WBK-Robotics/industrial-assembly-taskboard/docs/source/images/housing_part1_placement.png

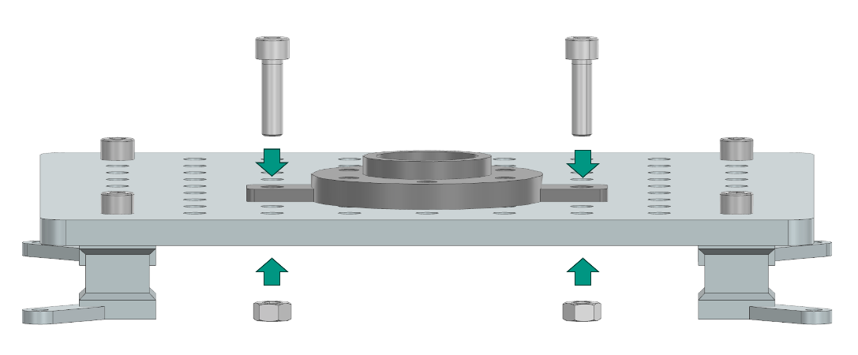
docs/source/images/housing_part1_placement.png
