WBK-Robotics/industrial-assembly-taskboard/docs/source/images/pick_and_place_taskboard.png

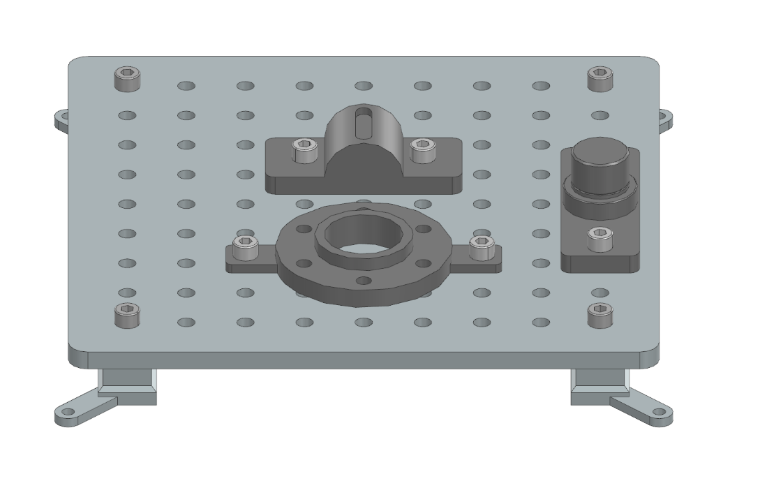
docs/source/images/pick_and_place_taskboard.png
