WBK-Robotics/industrial-assembly-taskboard/docs/source/images/pick_and_place_taskboard_feather_key.png

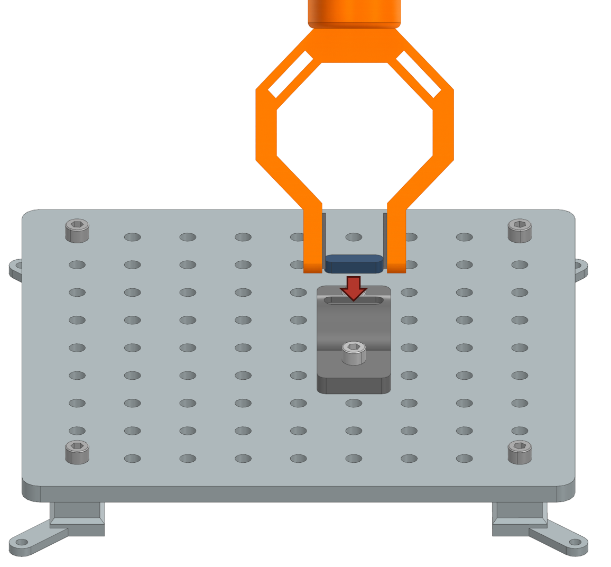
docs/source/images/pick_and_place_taskboard_feather_key.png
