WBK-Robotics/industrial-assembly-taskboard/docs/source/images/pick_and_place_taskboard_shim_rings.png

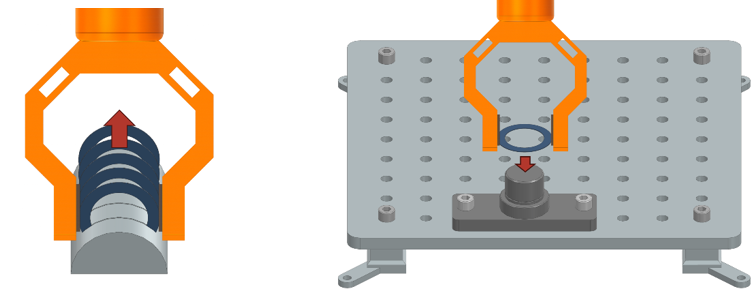
docs/source/images/pick_and_place_taskboard_shim_rings.png
