WBK-Robotics/industrial-assembly-taskboard/docs/source/images/pick_and_place_taskboard_housing_parts.png

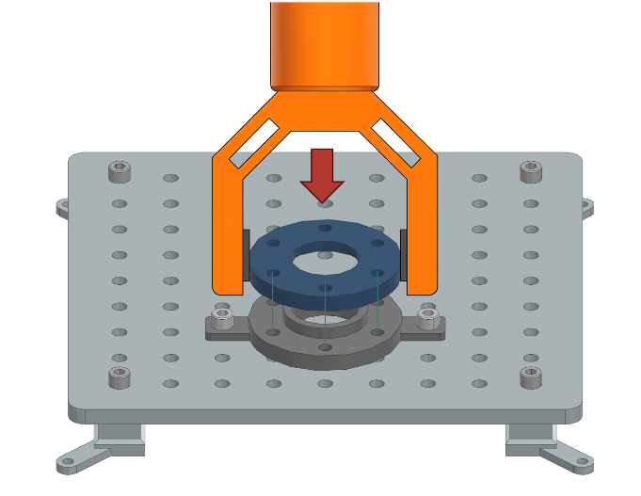
docs/source/images/pick_and_place_taskboard_housing_parts.png
