WBK-Robotics/industrial-assembly-taskboard/3d_printing_files/2 Pick and Place Tasks/Task2-Feather Key/STL/Feather Key Assembly.stl

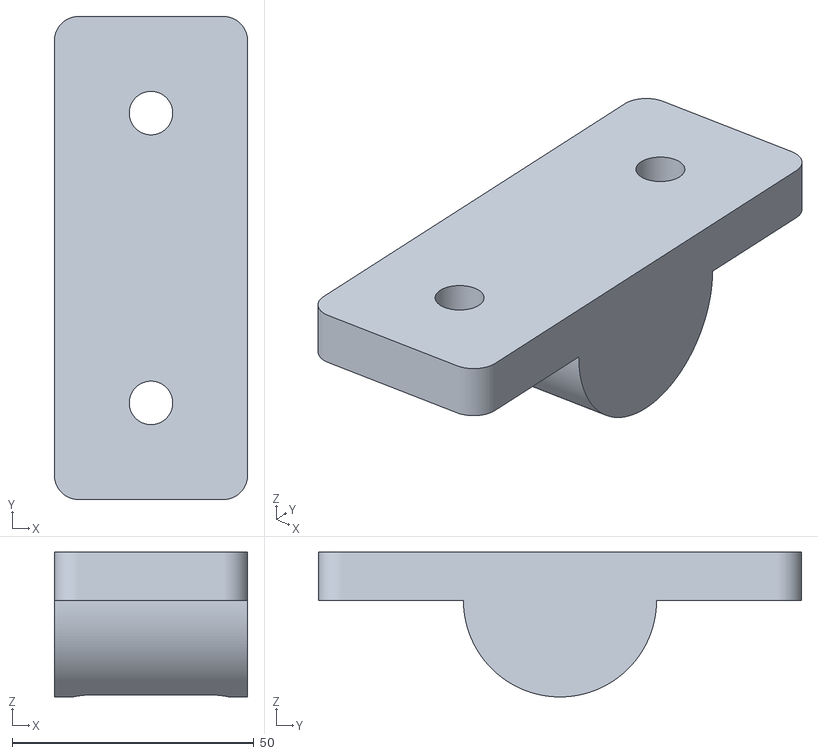
[picture p9: CAD file, 2025-06-06]
3d_printing_files/2 Pick and Place Tasks/Task2-Feather Key/STL/Feather Key Assembly.stl
40.0 x 100.0 x 30.0
