WBK-Robotics/industrial-assembly-taskboard/3d_printing_files/5 Elastic Deformation Tasks/Task1_Snap Hook/STL/Snap Hook Assembly.stl

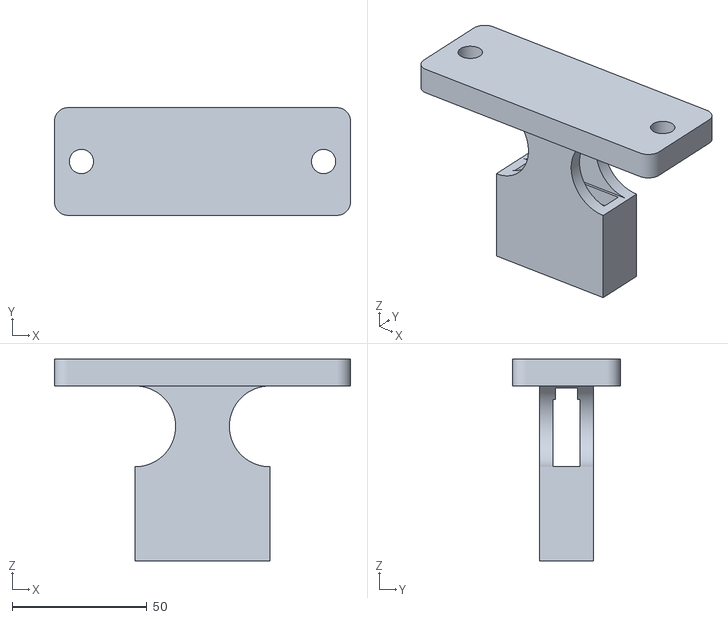
[picture p10: CAD file, 2025-06-06]
3d_printing_files/5 Elastic Deformation Tasks/Task1_Snap Hook/STL/Snap Hook Assembly.stl
110.0 x 40.0 x 75.0
