WBK-Robotics/industrial-assembly-taskboard/3d_printing_files/5 Elastic Deformation Tasks/Task2_Spring/Pressure Spring Assembly.stl

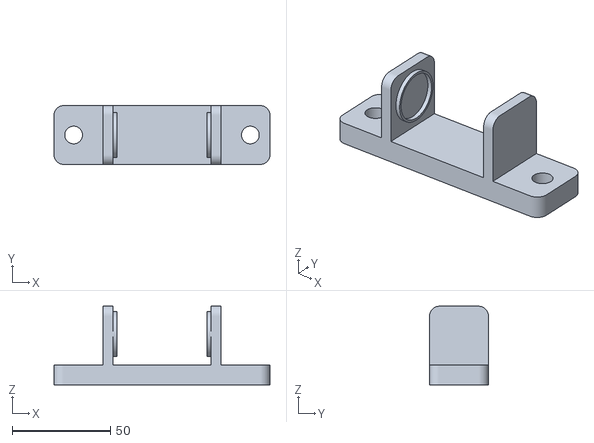
[picture p11: CAD file, 2025-06-06]
3d_printing_files/5 Elastic Deformation Tasks/Task2_Spring/Pressure Spring Assembly.stl
110.0 x 30.0 x 40.0
