WBK-Robotics/industrial-assembly-taskboard/3d_printing_files/5 Elastic Deformation Tasks/Task3_Circlip/Circlip Assembly.stl

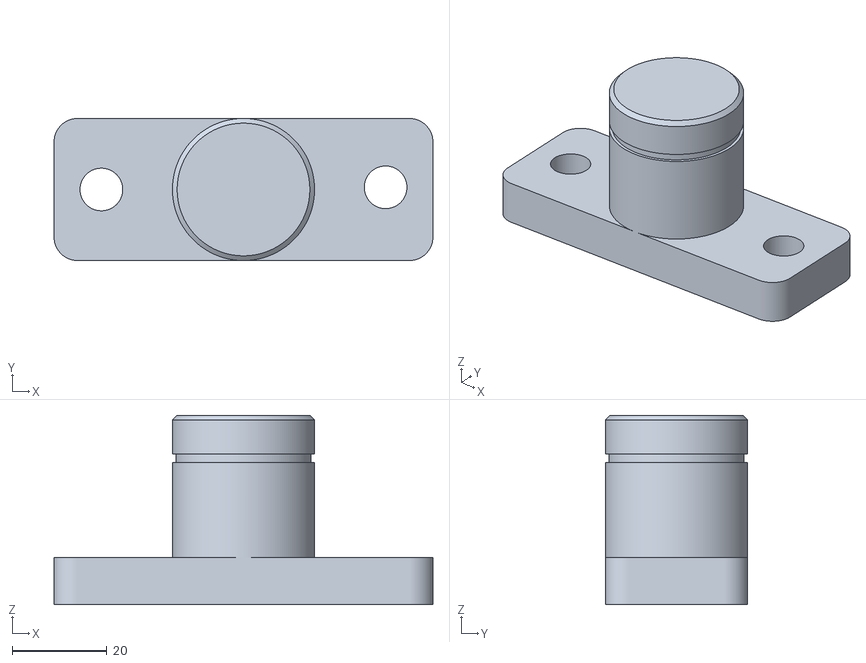
[picture p12: CAD file, 2025-06-06]
3d_printing_files/5 Elastic Deformation Tasks/Task3_Circlip/Circlip Assembly.stl
80.0 x 30.0 x 40.0
