WBK-Robotics/industrial-assembly-taskboard/3d_printing_files/2 Pick and Place Tasks/Task3-Shim Ring/STL/Shim Ring Assembly.stl

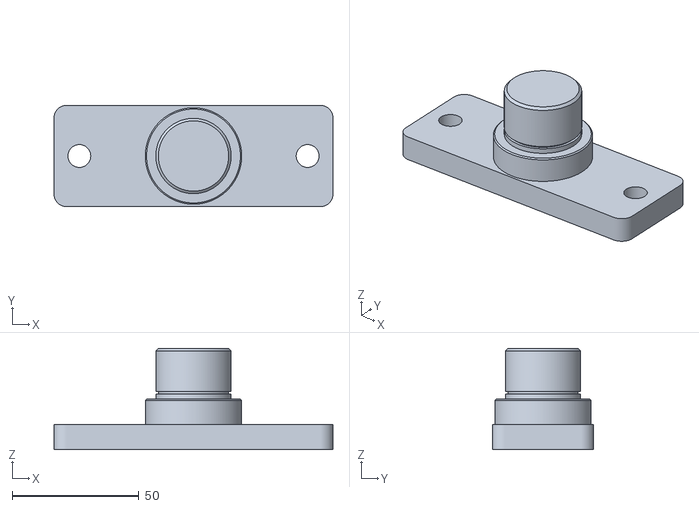
[picture p13: CAD file, 2025-06-06]
3d_printing_files/2 Pick and Place Tasks/Task3-Shim Ring/STL/Shim Ring Assembly.stl
110.0 x 40.0 x 40.0
