WBK-Robotics/industrial-assembly-taskboard/3d_printing_files/1 Peg in Hole Tasks/Task1-Round Shaft/3D-Print only/STL/Peg Round.stl

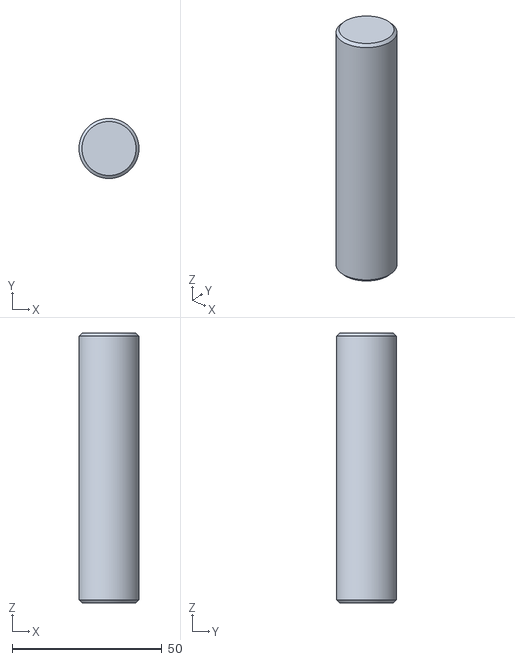
[picture p14: CAD file, 2025-06-06]
3d_printing_files/1 Peg in Hole Tasks/Task1-Round Shaft/3D-Print only/STL/Peg Round.stl
20.0 x 20.0 x 90.0
