WBK-Robotics/industrial-assembly-taskboard/3d_printing_files/1 Peg in Hole Tasks/Task2-Splined Shaft/3D-Printed only/STL/Splined_shaft_peg.stl

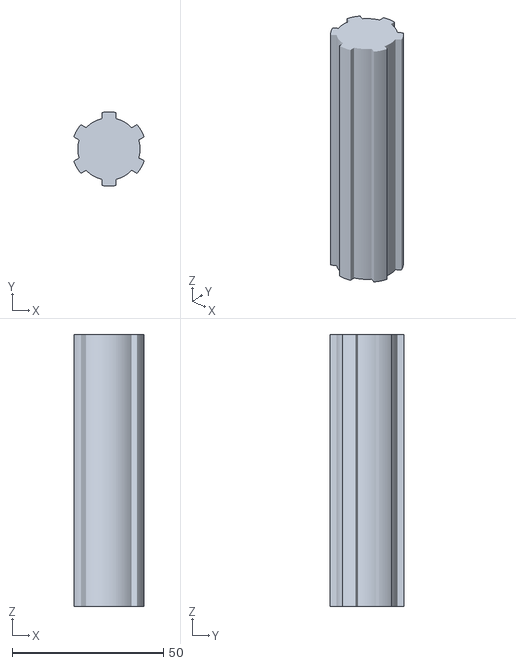
[picture p16: CAD file, 2025-06-06]
3d_printing_files/1 Peg in Hole Tasks/Task2-Splined Shaft/3D-Printed only/STL/Splined_shaft_peg.stl
23.3 x 24.6 x 90.0
