WBK-Robotics/industrial-assembly-taskboard/3d_printing_files/1 Peg in Hole Tasks/Task2-Splined Shaft/Shaft and Sleeve/STL/Hole Splined Shaft.stl

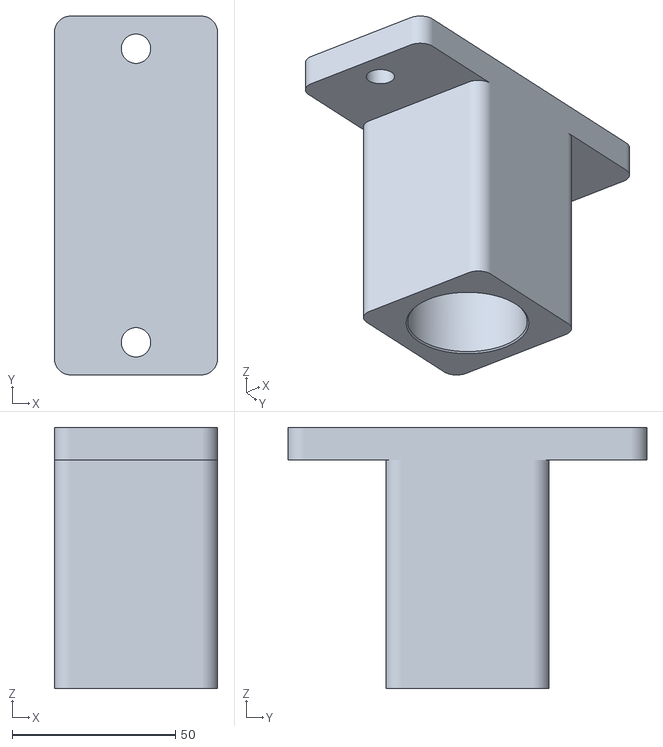
[picture p17: CAD file, 2025-06-06]
3d_printing_files/1 Peg in Hole Tasks/Task2-Splined Shaft/Shaft and Sleeve/STL/Hole Splined Shaft.stl
50.0 x 110.0 x 80.0
