WBK-Robotics/industrial-assembly-taskboard/3d_printing_files/1 Peg in Hole Tasks/Task3-BNC Connector/Mounting BNC Connector.stl

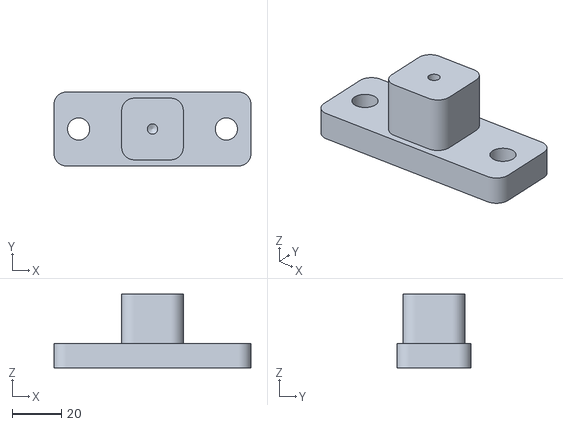
[picture p18: CAD file, 2025-06-06]
3d_printing_files/1 Peg in Hole Tasks/Task3-BNC Connector/Mounting BNC Connector.stl
80.0 x 30.0 x 30.0
