WBK-Robotics/industrial-assembly-taskboard/3d_printing_files/2 Pick and Place Tasks/Task1-Housing/STL/Housing Part2.stl

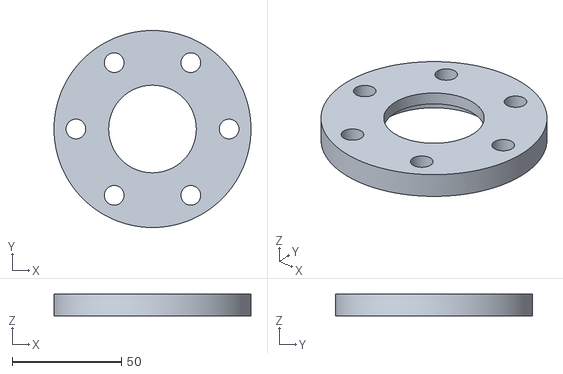
[picture p19: CAD file, 2025-06-06]
3d_printing_files/2 Pick and Place Tasks/Task1-Housing/STL/Housing Part2.stl
90.0 x 90.0 x 10.0
