WBK-Robotics/industrial-assembly-taskboard/3d_printing_files/2 Pick and Place Tasks/Task3-Shim Ring/STL/Shim Ring Magazine.stl

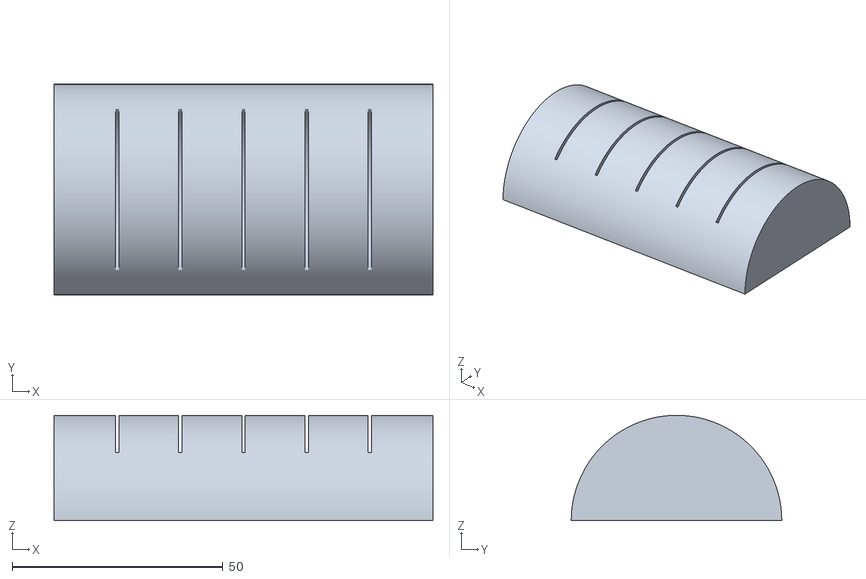
[picture p20: CAD file, 2025-06-06]
3d_printing_files/2 Pick and Place Tasks/Task3-Shim Ring/STL/Shim Ring Magazine.stl
90.0 x 50.0 x 25.0
