WBK-Robotics/industrial-assembly-taskboard/3d_printing_files/3 Gear Assembly Tasks/Task1 2 Gears/STL/2 Gears Mounting.stl

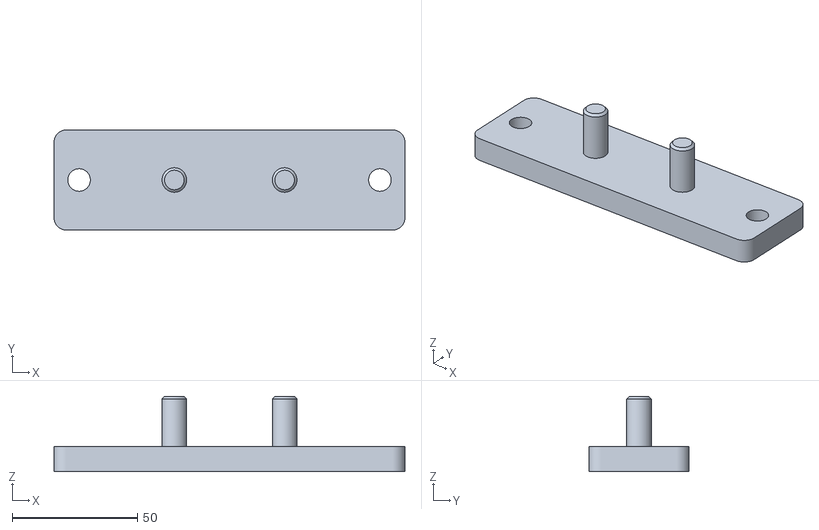
[picture p21: CAD file, 2025-06-06]
3d_printing_files/3 Gear Assembly Tasks/Task1 2 Gears/STL/2 Gears Mounting.stl
140.0 x 40.0 x 30.0
