WBK-Robotics/industrial-assembly-taskboard/3d_printing_files/3 Gear Assembly Tasks/Task2 2 Gears with helical Teeth/STL/Helical Gear.stl

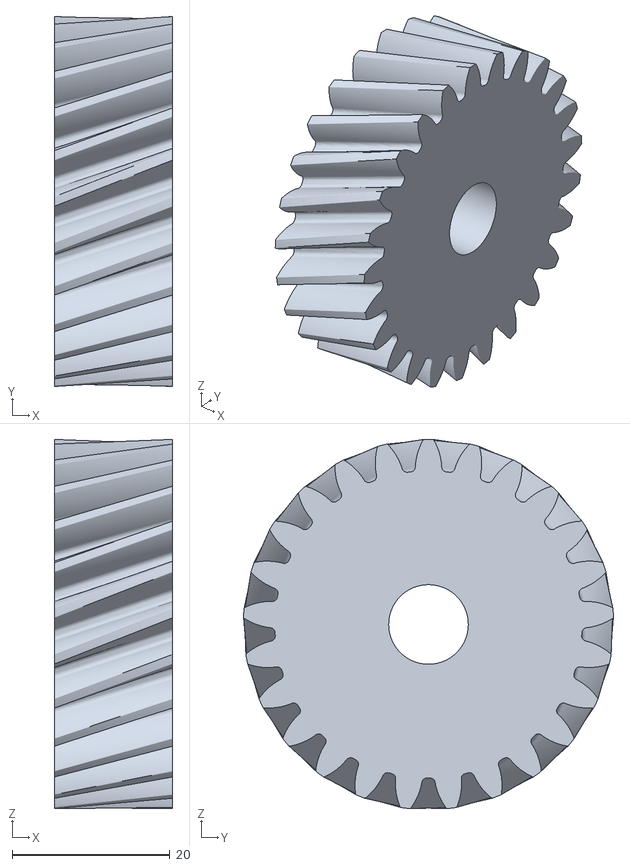
[picture p22: CAD file, 2025-06-06]
3d_printing_files/3 Gear Assembly Tasks/Task2 2 Gears with helical Teeth/STL/Helical Gear.stl
15.0 x 47.0 x 46.9
