WBK-Robotics/industrial-assembly-taskboard/3d_printing_files/3 Gear Assembly Tasks/Task3 3 Gears/STL/Gear 3 with Groove_2pcs.stl

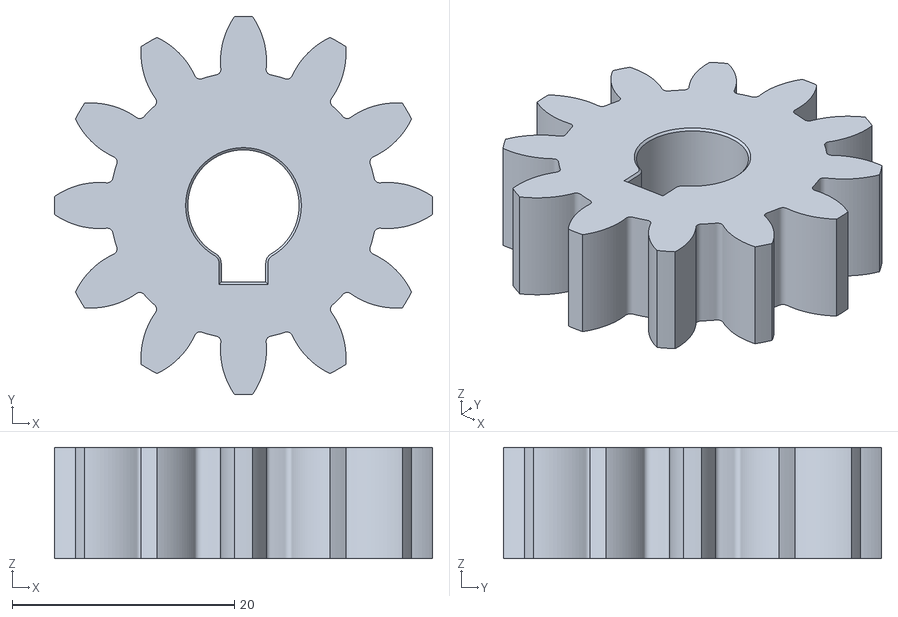
[picture p23: CAD file, 2025-06-06]
3d_printing_files/3 Gear Assembly Tasks/Task3 3 Gears/STL/Gear 3 with Groove_2pcs.stl
34.0 x 34.0 x 10.0
