WBK-Robotics/industrial-assembly-taskboard/3d_printing_files/Taskboard/STL/Taskboard.stl

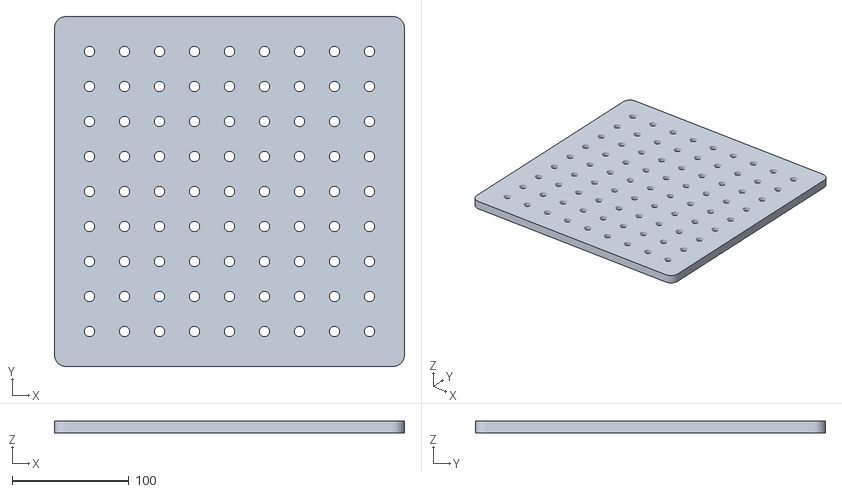
[picture p24: CAD file, 2025-06-24]
3d_printing_files/Taskboard/STL/Taskboard.stl
300.0 x 300.0 x 10.0
