WBK-Robotics/industrial-assembly-taskboard/3d_printing_files/1 Peg in Hole Tasks/Task1-Round Shaft/3D-Print only/STL/Hole Round.stl

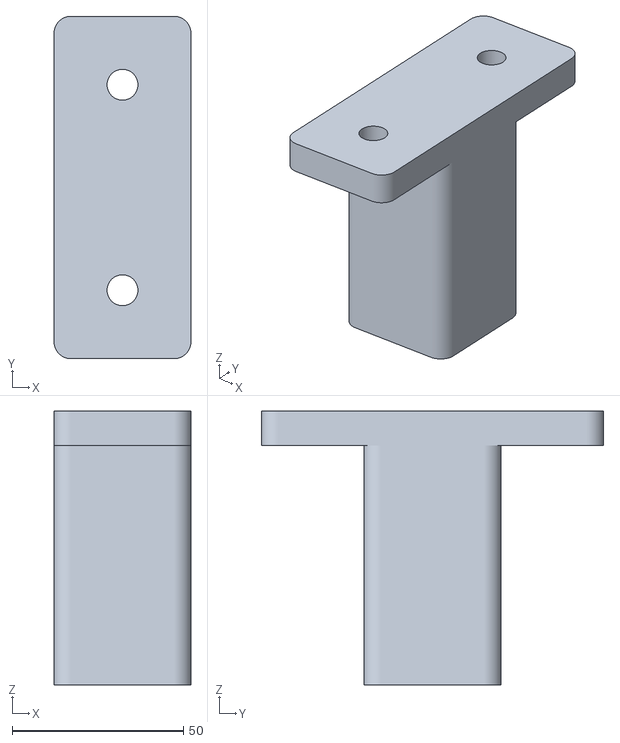
[picture p25: CAD file, 2025-06-06]
3d_printing_files/1 Peg in Hole Tasks/Task1-Round Shaft/3D-Print only/STL/Hole Round.stl
40.0 x 100.0 x 80.0
