WBK-Robotics/industrial-assembly-taskboard/3d_printing_files/1 Peg in Hole Tasks/Task2-Splined Shaft/3D-Printed only/STL/Splined_shaft_hole.stl

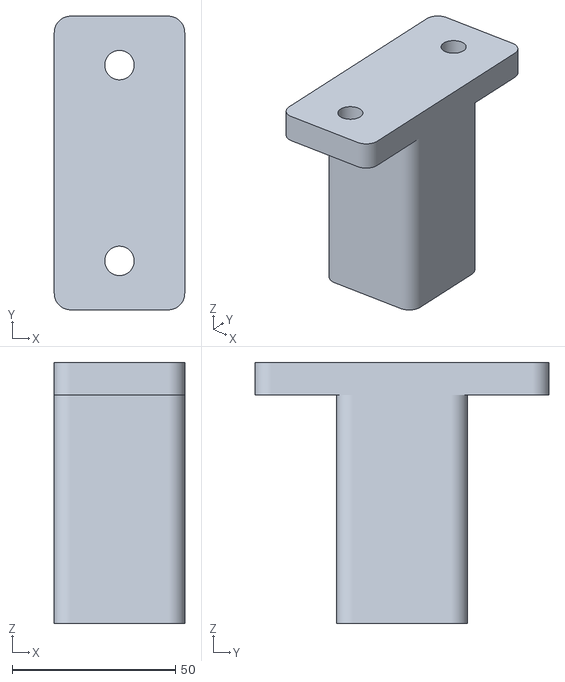
[picture p26: CAD file, 2025-06-06]
3d_printing_files/1 Peg in Hole Tasks/Task2-Splined Shaft/3D-Printed only/STL/Splined_shaft_hole.stl
40.0 x 90.0 x 80.0
