WBK-Robotics/industrial-assembly-taskboard/3d_printing_files/2 Pick and Place Tasks/Task2-Feather Key/STL/Feather Key.stl

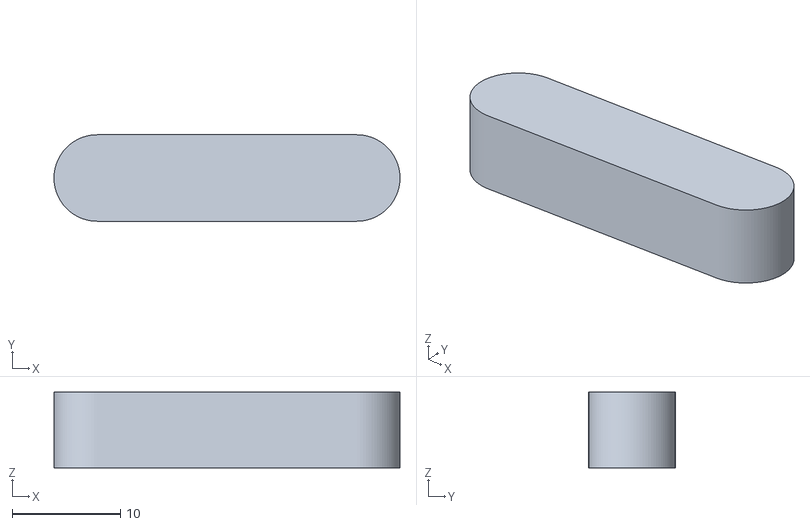
[picture p28: CAD file, 2025-06-06]
3d_printing_files/2 Pick and Place Tasks/Task2-Feather Key/STL/Feather Key.stl
32.0 x 8.00 x 7.00
