WBK-Robotics/industrial-assembly-taskboard/3d_printing_files/3 Gear Assembly Tasks/Task1 2 Gears/STL/Gear 1.stl

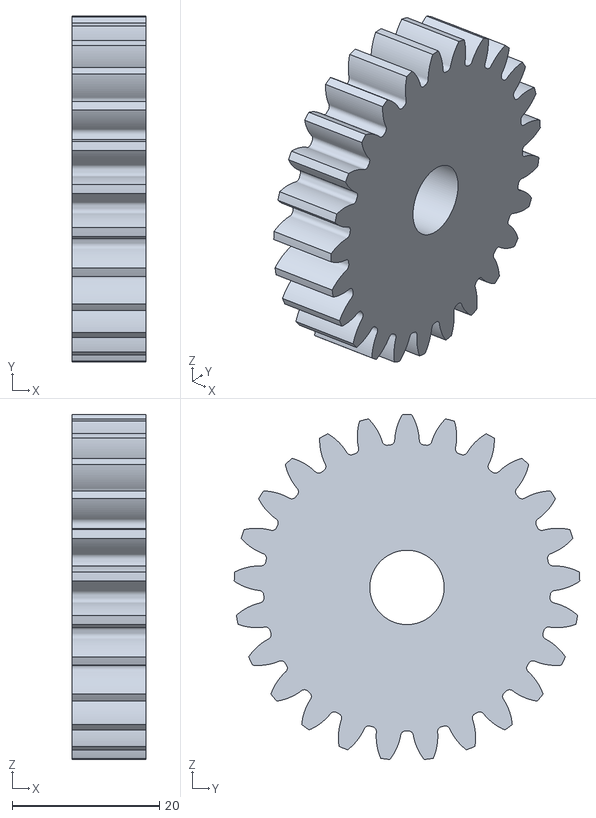
[picture p29: CAD file, 2025-06-06]
3d_printing_files/3 Gear Assembly Tasks/Task1 2 Gears/STL/Gear 1.stl
10.0 x 47.0 x 46.9
