WBK-Robotics/industrial-assembly-taskboard/3d_printing_files/3 Gear Assembly Tasks/Task3 3 Gears/STL/3 Gears Mounting Part 1.stl

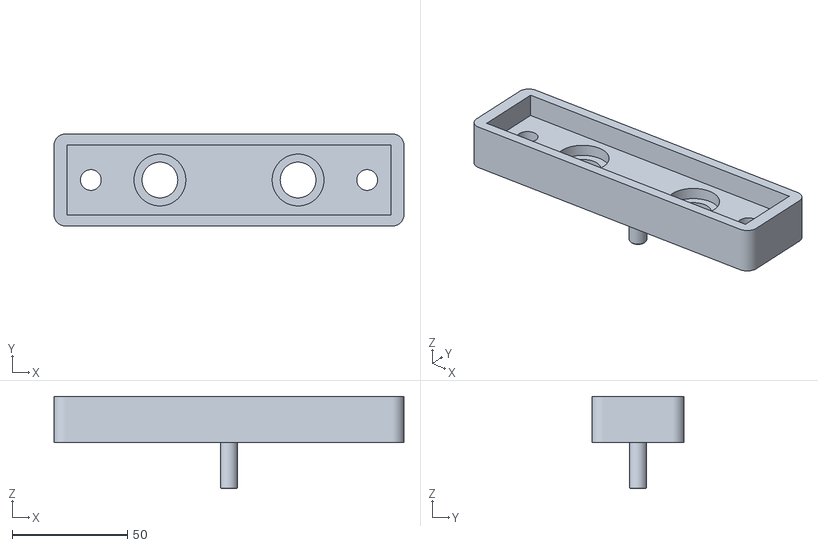
[picture p30: CAD file, 2025-06-06]
3d_printing_files/3 Gear Assembly Tasks/Task3 3 Gears/STL/3 Gears Mounting Part 1.stl
152.0 x 40.0 x 40.0
