WBK-Robotics/industrial-assembly-taskboard/3d_printing_files/5 Elastic Deformation Tasks/Task1_Snap Hook/STL/Snap Hook (horizontal 3D printing).stl

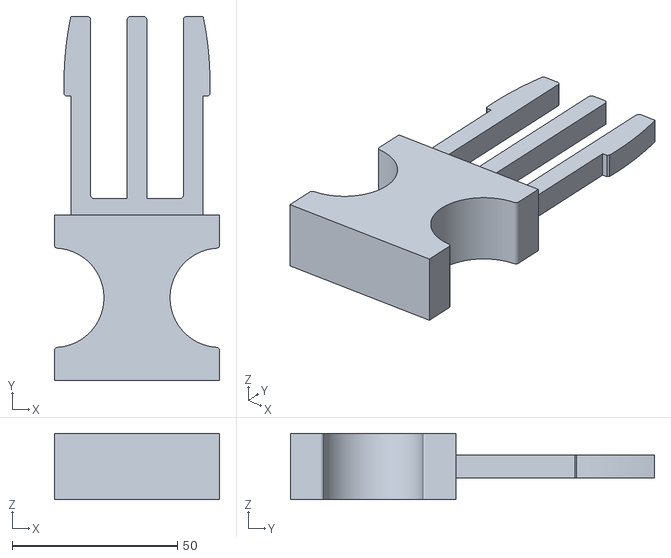
[picture p31: CAD file, 2025-06-06]
3d_printing_files/5 Elastic Deformation Tasks/Task1_Snap Hook/STL/Snap Hook (horizontal 3D printing).stl
50.0 x 110.0 x 20.0
