WBK-Robotics/industrial-assembly-taskboard/3d_printing_files/Taskboard/STL/Taskboard Foot-4pcs.stl

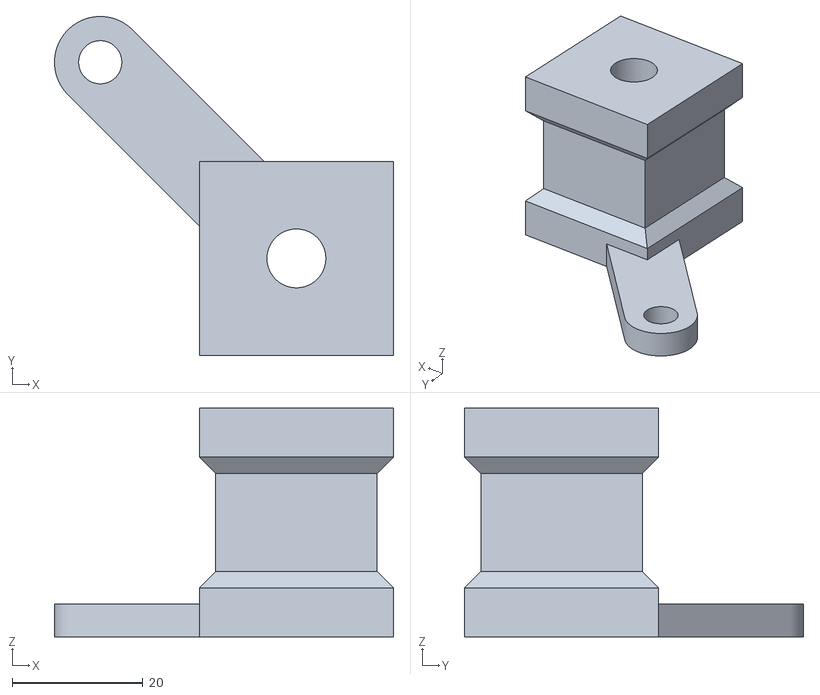
[picture p32: CAD file, 2025-06-24]
3d_printing_files/Taskboard/STL/Taskboard Foot-4pcs.stl
51.8 x 51.8 x 35.0
