WBK-Robotics/industrial-assembly-taskboard/3d_printing_files/3 Gear Assembly Tasks/Task3 3 Gears/STL/Shaft with Key_2pcs.stl

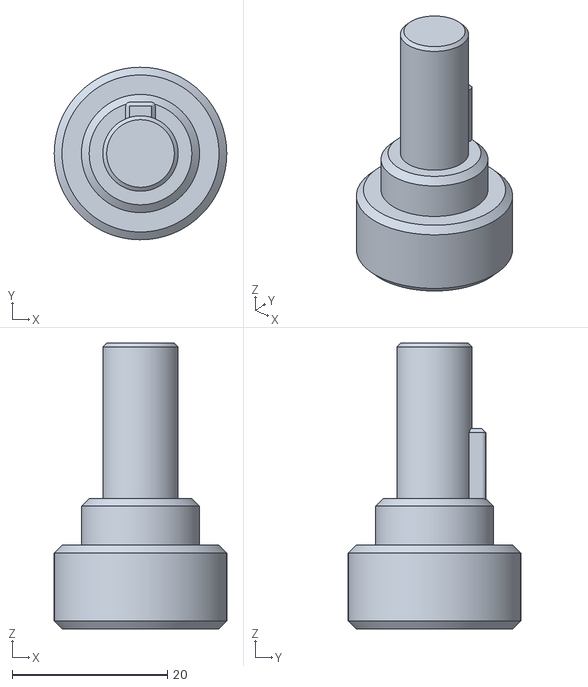
[picture p33: CAD file, 2025-06-06]
3d_printing_files/3 Gear Assembly Tasks/Task3 3 Gears/STL/Shaft with Key_2pcs.stl
22.2 x 22.2 x 36.8
