WBK-Robotics/industrial-assembly-taskboard/3d_printing_files/3 Gear Assembly Tasks/Task3 3 Gears/STL/3 Gears Mounting Part 2.stl

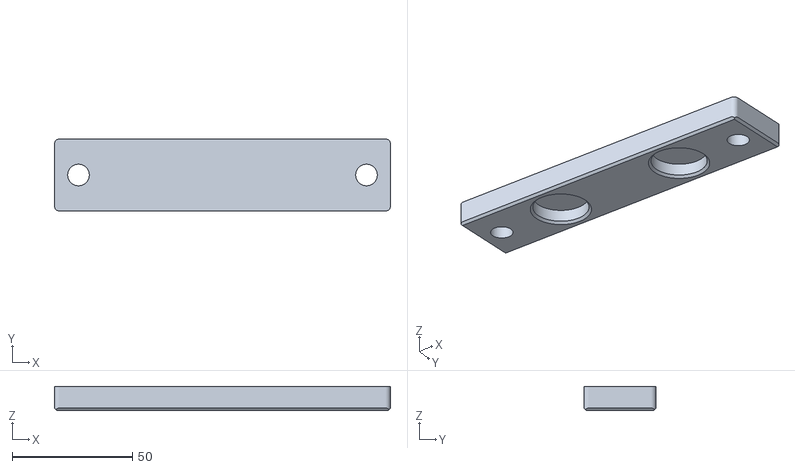
[picture p34: CAD file, 2025-06-06]
3d_printing_files/3 Gear Assembly Tasks/Task3 3 Gears/STL/3 Gears Mounting Part 2.stl
140.0 x 30.0 x 10.0
