WBK-Robotics/industrial-assembly-taskboard/(list of files, cad)

Other CAD files:
3d_printing_files/3 Gear Assembly Tasks/Task3 3 Gears/STL/Gear 3.stl
3d_printing_files/1 Peg in Hole Tasks/Task1-Round Shaft/3D-Print only/CAD/Hole round.prt
3d_printing_files/1 Peg in Hole Tasks/Task1-Round Shaft/3D-Print only/CAD/Peg round.prt
3d_printing_files/1 Peg in Hole Tasks/Task1-Round Shaft/Shaft and Bearing/CAD/Hole round.prt
3d_printing_files/1 Peg in Hole Tasks/Task1-Round Shaft/Shaft and Bearing/CAD/MPBZ20-50_stp.prt
3d_printing_files/1 Peg in Hole Tasks/Task1-Round Shaft/Shaft and Bearing/CAD/PSFG20-100_stp.prt
3d_printing_files/1 Peg in Hole Tasks/Task1-Round Shaft/Shaft and Bearing/CAD/Peg in Hole Assembly.prt
3d_printing_files/1 Peg in Hole Tasks/Task2-Splined Shaft/3D-Printed only/CAD/Hole splined shaft.prt
3d_printing_files/1 Peg in Hole Tasks/Task2-Splined Shaft/3D-Printed only/CAD/Peg splined shaft.prt
3d_printing_files/1 Peg in Hole Tasks/Task2-Splined Shaft/Shaft and Sleeve/CAD/Hole Splined Shaft.prt
3d_printing_files/1 Peg in Hole Tasks/Task2-Splined Shaft/Shaft and Sleeve/CAD/Splined shaft bearing.prt
3d_printing_files/1 Peg in Hole Tasks/Task2-Splined Shaft/Shaft and Sleeve/CAD/Splined shaft.prt
3d_printing_files/1 Peg in Hole Tasks/Task3-BNC Connector/Mounting BNC Connector.prt
3d_printing_files/2 Pick and Place Tasks/Task1-Housing/CAD/Housing Assembly Group.prt
3d_printing_files/2 Pick and Place Tasks/Task1-Housing/CAD/Housing Part1.prt
3d_printing_files/2 Pick and Place Tasks/Task1-Housing/CAD/Housing Part2.prt
3d_printing_files/2 Pick and Place Tasks/Task2-Feather Key/CAD/Assembly Group Feather Key.prt
3d_printing_files/2 Pick and Place Tasks/Task2-Feather Key/CAD/Feather Key Assembly.prt
3d_printing_files/2 Pick and Place Tasks/Task2-Feather Key/CAD/Feather Key.prt
3d_printing_files/2 Pick and Place Tasks/Task3-Shim Ring/CAD/Magazin Filled.prt
3d_printing_files/2 Pick and Place Tasks/Task3-Shim Ring/CAD/Shim Ring Assembly Group.prt
3d_printing_files/2 Pick and Place Tasks/Task3-Shim Ring/CAD/Shim Ring Assembly.prt
3d_printing_files/2 Pick and Place Tasks/Task3-Shim Ring/CAD/Shim Ring Magazine.prt
3d_printing_files/2 Pick and Place Tasks/Task3-Shim Ring/CAD/Shim Ring.prt
3d_printing_files/3 Gear Assembly Tasks/Task1 2 Gears/CAD/2 Gears Module.prt
3d_printing_files/3 Gear Assembly Tasks/Task1 2 Gears/CAD/2 Gears Mounting.prt
3d_printing_files/3 Gear Assembly Tasks/Task1 2 Gears/CAD/Gear 1.prt
3d_printing_files/3 Gear Assembly Tasks/Task2 2 Gears with helical Teeth/CAD/Helical Gear Assembly Group.prt
3d_printing_files/3 Gear Assembly Tasks/Task2 2 Gears with helical Teeth/CAD/Helical Gear Assembly.prt
3d_printing_files/3 Gear Assembly Tasks/Task2 2 Gears with helical Teeth/CAD/Helical Gear.prt
3d_printing_files/3 Gear Assembly Tasks/Task3 3 Gears/CAD/3 Gears Module.prt
3d_printing_files/3 Gear Assembly Tasks/Task3 3 Gears/CAD/3 Gears Mounting 1.prt
3d_printing_files/3 Gear Assembly Tasks/Task3 3 Gears/CAD/3 Gears Mounting 2.prt
3d_printing_files/3 Gear Assembly Tasks/Task3 3 Gears/CAD/Gear 3 with Groove.prt
3d_printing_files/3 Gear Assembly Tasks/Task3 3 Gears/CAD/Gear 3.prt
3d_printing_files/3 Gear Assembly Tasks/Task3 3 Gears/CAD/Shaft with Key.prt
3d_printing_files/4 Screws and Nuts Tasks/Task1-Hexagon Socket Screw/CAD/Screw_assembly.prt
3d_printing_files/4 Screws and Nuts Tasks/Task1-Hexagon Socket Screw/STL/Screw Assembly.stl
3d_printing_files/4 Screws and Nuts Tasks/Task2-Nut Difficult Accessebilaty/CAD/Nut Assembly Group.prt
3d_printing_files/4 Screws and Nuts Tasks/Task2-Nut Difficult Accessebilaty/CAD/Nut Assembly.prt
3d_printing_files/4 Screws and Nuts Tasks/Task2-Nut Difficult Accessebilaty/CAD/Thread insert model.prt
3d_printing_files/4 Screws and Nuts Tasks/Task2-Nut Difficult Accessebilaty/STL/Nut Assembly.stl
3d_printing_files/4 Screws and Nuts Tasks/Task3-Tilting of Screws/CAD/Screws Tilting Part1.prt
3d_printing_files/4 Screws and Nuts Tasks/Task3-Tilting of Screws/CAD/Screws Tilting Part2.prt
3d_printing_files/4 Screws and Nuts Tasks/Task3-Tilting of Screws/Instructions/Assembly_group_screws_tilting.prt
3d_printing_files/4 Screws and Nuts Tasks/Task3-Tilting of Screws/Instructions/Assembly_group_screws_tilting_manually_assembled.prt
3d_printing_files/4 Screws and Nuts Tasks/Task3-Tilting of Screws/Instructions/PRT1_Screws_tilting.prt
3d_printing_files/4 Screws and Nuts Tasks/Task3-Tilting of Screws/Instructions/PRT2_Screws_tilting.prt
3d_printing_files/4 Screws and Nuts Tasks/Task3-Tilting of Screws/Instructions/Thread insert model.prt
3d_printing_files/4 Screws and Nuts Tasks/Task3-Tilting of Screws/STL/Screws Tilting Part1.stl
3d_printing_files/4 Screws and Nuts Tasks/Task3-Tilting of Screws/STL/Screws Tilting Part2.stl
3d_printing_files/5 Elastic Deformation Tasks/Task1_Snap Hook/CAD/Snap Hook Assembly.prt
3d_printing_files/5 Elastic Deformation Tasks/Task1_Snap Hook/CAD/Snap Hook.prt
3d_printing_files/5 Elastic Deformation Tasks/Task2_Spring/Pressure Spring Assembly.prt
3d_printing_files/5 Elastic Deformation Tasks/Task3_Circlip/Circlip Assembly.prt
3d_printing_files/Taskboard/CAD/PRT_Mutter_DIN_934_M8.prt
3d_printing_files/Taskboard/CAD/PRT_Schraube_DIN_912_M8_30mm.prt
3d_printing_files/Taskboard/CAD/Task Board Assembly Completed.prt
3d_printing_files/Taskboard/CAD/Taskboard Foot.prt
3d_printing_files/Taskboard/CAD/Taskboard.prt
