WBK-Robotics/industrial-assembly-taskboard/3d_printing_files/1 Peg in Hole Tasks/README.md

# Peg in Hole Tasks

This folder contains 3D-printable files for the "Peg in Hole" tasks, which are part of the Industrial Assembly Task Board. These tasks are designed to evaluate a robot's ability to handle precise insertion operations, a fundamental skill in robotic assembly.

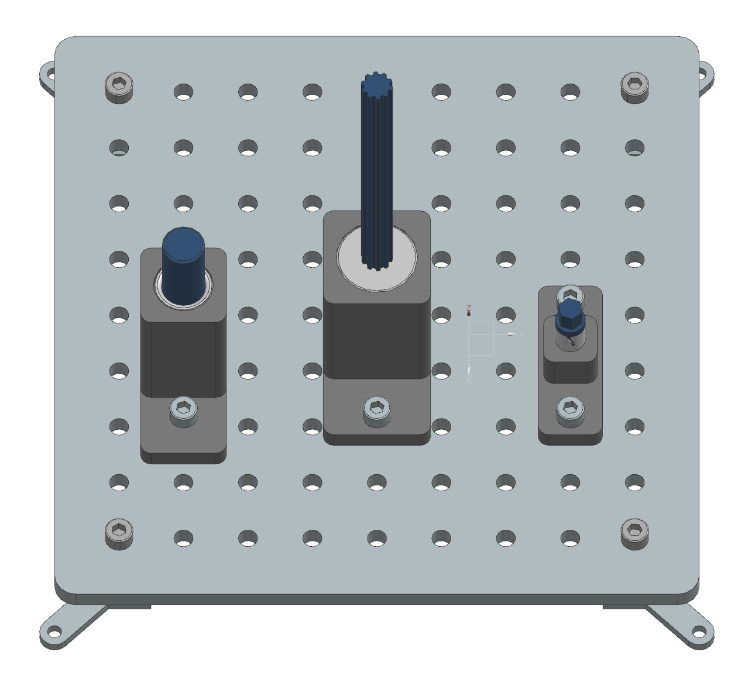
[picture p35: docs/source/images/peg_in_hole_taskboard_finished.png]
Peg in Hole Task Board


## Tasks Overview

1. **Task 1: Round Shaft**
   - Involves inserting a round peg into a matching round hole.
   - Tests the robot's ability to align and insert components with minimal interference.

2. **Task 2: Splined Shaft**
   - Requires inserting a splined peg into a matching splined hole.
   - Evaluates the robot's capability to handle keyed components that require precise orientation.

3. **Task 3: BNC Connector**
   - Simulates the insertion of a BNC connector into its socket.
   - Challenges the robot to manage components with complex geometries and alignment requirements.

## How to Use

1. Navigate to the subfolder for the specific task you want to build.
2. Use the provided 3D-printable files to fabricate the components.
3. Follow the assembly instructions in the documentation to set up the task.

## Contributing

If you have ideas for additional "Peg in Hole" tasks, please contribute by:

1. Creating the necessary 3D-printable files.
2. Writing a task description and success criteria.
3. Opening a Pull Request in the [main repository](https://github.com/WBK-Robotics/industrial-assembly-taskboard).

Your contributions will help expand the benchmark and advance robotic assembly systems.
