WBK-Robotics/industrial-assembly-taskboard/docs/source/5-Assembly-Instructions-Elastic-Deformation.rst

Assembly Instructions: Elastic Deformation
==========================================

This section provides step-by-step instructions for assembling the Elastic Deformation task module of the Industrial Assembly Task Board. 
The module consists of three tasks: Snap Hook, Spring, and Circlip.

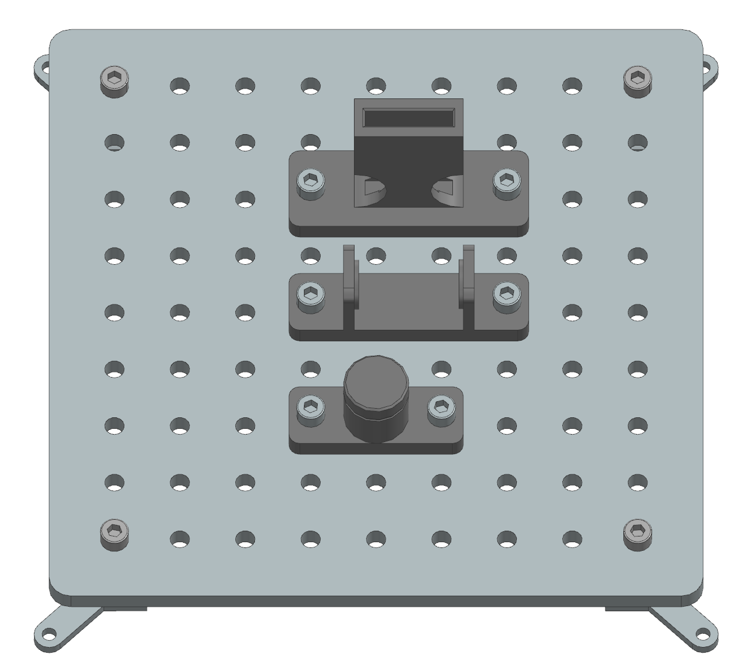
[picture p53: docs/source/images/elastic_deformation_taskboard.png]
Elastic Deformation Task Module


Task 1: Snap Hook
-----------------

Step 1: Prepare the Components
^^^^^^^^^^^^^^^^^^^^^^^^^^^^^^

.. list-table::
   :header-rows: 1
   :align: center

   * - 3D-printed parts
     - Purchased components
   * - Snap Hook x 1 (Material: PETG)
     - M8 Nut x 2
   * - Snap Hook Assembly x 1 (Material: PETG)
     - 30mm M8 Screw x 2

Step 2: Manual fixation of the housing on the Task Board
^^^^^^^^^^^^^^^^^^^^^^^^^^^^^^^^^^^^^^^^^^^^^^^^^^^^^^^^

Align the two holes on the side of the Snap Hook Assembly component with any two suitable holes on the Taskboard. Then push two 30mm M8 screws through the aligned holes and secure them from the bottom of the Taskboard with M8 nuts.

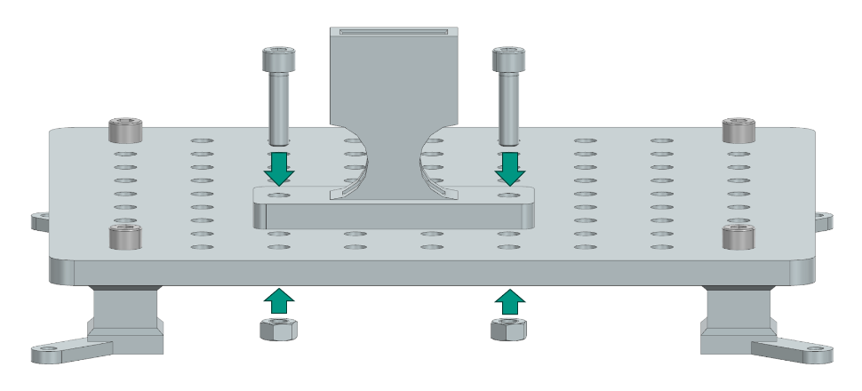
[picture p54: docs/source/images/snap_hook_placement.png]
Snap Hook placement


Place the Snap Hook on a flat surface next to the Taskboard so that the Robot can grasp it.

Task 2: Spring
--------------

Step 1: Prepare the Components
^^^^^^^^^^^^^^^^^^^^^^^^^^^^^^

.. list-table::
   :header-rows: 1
   :align: center

   * - 3D-printed parts
     - Purchased components
   * - Pressure Spring Assembly x 1 (Material: PETG)
     - M8 Nut x 2
   * -
     - 30mm M8 Screw x 2
   * -
     - Spring WF20-80 x 1

Step 2: Manual fixation of the housing on the Task Board
^^^^^^^^^^^^^^^^^^^^^^^^^^^^^^^^^^^^^^^^^^^^^^^^^^^^^^^^

Align the two holes on the side of the Pressure Spring Assembly component with any two suitable holes on the Taskboard. Then, push two 30mm M8 Screws through the aligned holes and secure them from the bottom of the Taskboard with M8 Nuts.
Place the Spring on a flat surface next to the Taskboard to allow the robot to grasp it.

Task 3: Circlip
---------------

Step 1: Prepare the Components
^^^^^^^^^^^^^^^^^^^^^^^^^^^^^^

Step 2: Manual fixation of the housing on the Task Board
^^^^^^^^^^^^^^^^^^^^^^^^^^^^^^^^^^^^^^^^^^^^^^^^^^^^^^^^

Align the two holes on the side of the Circlip Assembly component with any two suitable holes on the Taskboard. Then push two 30mm M8 screws through the aligned holes and secure them from the bottom of the Taskboard with M8 nuts.
Place the circlip on a flat surface next to the Taskboard to allow the robot to grasp it.

.. list-table::
   :header-rows: 1
   :align: center

   * - 3D-printed parts
     - Purchased components
   * - Circlip Assembly x 1 (Material: PETG)
     - M8 Nut x 2
   * -
     - 30mm M8 Screw x 2
   * -
     - 30 Circlip x 1
