WBK-Robotics/industrial-assembly-taskboard/docs/source/images/shim_ring_assembly_placement.png

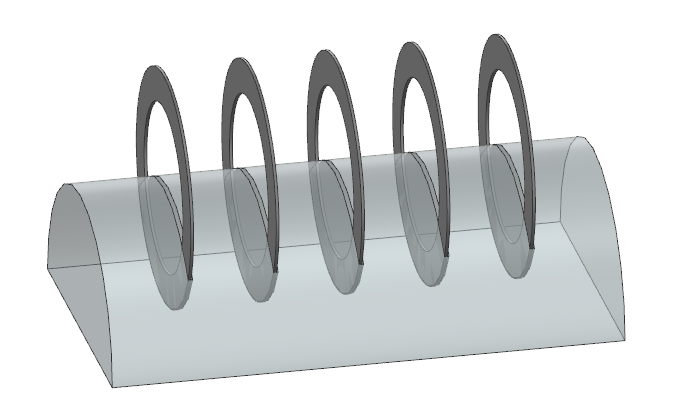
docs/source/images/shim_ring_assembly_placement.png
