WBK-Robotics/industrial-assembly-taskboard/(commit log)

2025-06-06 added files for 3d printing
    [2 Gears Module.prt, 2 Gears Mounting.prt, 2 Gears Mounting.stl, 3 Gears Module.prt, 3 Gears Mounting 1.prt, 3 Gears Mounting 2.prt, 3 Gears Mounting Part 1.stl, 3 Gears Mounting Part 2.stl]
2025-06-24 added taskboard files
    [PRT_Mutter_DIN_934_M8.prt, PRT_Schraube_DIN_912_M8_30mm.prt, Task Board Assembly Completed.prt, Taskboard Foot-4pcs.stl, Taskboard Foot.prt, Taskboard.prt, Taskboard.stl]
